wy165611/smart-warning-cone/docs/07-测试方案与数据记录表.md

# 测试方案与数据记录表

> **安全第一**：只在封闭场地（校内封闭道路、操场跑道、停车场空地）测试，使用自行车、电动车或遥控车，限速 30 km/h 以内，安排专人警戒。不得用车辆冲撞真人。

## 0. 已完成的软件验证（不需要硬件）

| 日期 | 项目 | 环境 | 结果 |
|---|---|---|---|
| 2026-11-01 | 四个固件编译 | arduino-cli，esp32:esp32 3.3.12，`esp32c3:CDCOnBoot=cdc`，Adafruit NeoPixel 1.15.5，PubSubClient 2.8 | 全部通过，`--warnings all` 无警告，程序空间 73%–74% |
| 2026-11-01 | 单元测试与静态检查 | Python 3.13，`pytest`、`ruff` | 23 项通过；lint、format 通过 |
| 2026-11-03 | 单元测试与静态检查 | Python 3.12.3，`pytest`、`ruff` | 34 项通过；`ruff check` 与 `ruff format --check` 通过 |
| 2026-11-03 | 四个固件编译 | arduino-cli 1.5.1，esp32:esp32 3.3.12，`esp32c3:CDCOnBoot=cdc`，Adafruit NeoPixel 1.15.5，PubSubClient 2.8 | `--warnings all` 无警告。程序空间上限 1310720 字节：哨兵 980009（74%），联动 967545（73%），工人端 964461（73%），网关 975527（74%）。动态内存上限 327680 字节：哨兵 36728（11%），联动 37856（11%），工人端 37800（11%），网关 39040（11%） |
| 2026-11-01 | 平台端到端 | 本机 amqtt broker + `python -m sentinel` + `tools/simulator.py` | 节点、事件、统计、报告接口正常（当时的截图已替换） |
| 2026-11-03 | 平台端到端 | Mosquitto 2.0.18 + `python -m sentinel` + `tools/simulator.py` | 模拟数据，不是路试。预警等级先保持 0，再进入一级、二级，离开后回到 0。第一次通过：最高等级 2，最高车速 37.32 km/h，最小 TTC 1.08 s，最近 11.24 m，持续 10301 ms。五个节点在线。截图 `docs/assets/dashboard-sim.png` |

以下各节是**实物测试**，目前都还没有做，表格保持空白，填之前不要在申报书或 PPT 中引用任何实测数字。

## 1. 测试设备

- 测速参考：手持测速雷达枪，或电动车码表 / 手机 GPS 测速 App；
- 测距参考：卷尺或激光测距仪，在路面每 10 m 贴标记；
- 计时：手机 240fps 慢动作视频；
- 数据记录：`tools/radar_monitor.py --csv`、服务器数据库。

## 2. 测速测距精度

**方法**：电动车分别以 10、15、20、25、30 km/h 匀速驶向雷达，每档 5 次。读取经过 20 m、40 m 标记时雷达输出的速度与距离。

| 序号 | 参考速度 km/h | 雷达速度 km/h | 误差 | 参考距离 m | 雷达距离 m | 误差 |
|---|---|---|---|---|---|---|
| 1 | | | | | | |
| 2 | | | | | | |
| … | | | | | | |

统计：平均绝对误差（MAE）、最大误差。

## 3. 最远检测距离

**方法**：车辆从 120 m 外驶来，记录雷达首次稳定检测到目标的距离。分白天/夜间/小雨各 5 次。

| 条件 | 1 | 2 | 3 | 4 | 5 | 平均 |
|---|---|---|---|---|---|---|
| 白天 | | | | | | |
| 夜间 | | | | | | |
| 小雨 | | | | | | |

## 4. 预警提前量

**方法**：车辆以 20、30 km/h 驶向锥桶，用视频记录一级、二级预警触发时刻和车辆到达锥桶时刻。

| 速度 | 一级触发距离 m | 一级提前量 s | 二级触发距离 m | 二级提前量 s |
|---|---|---|---|---|
| 20 | | | | |
| 30 | | | | |

## 5. 误报 / 漏报

- **误报**：锥桶放置 30 分钟，无测试车辆驶向锥桶（可有行人、旁边车道远离车辆），记录误触发次数。
- **漏报**：车辆以超过阈值的条件驶近 20 次，记录未触发次数。

| 项目 | 次数 | 触发/未触发 | 比率 |
|---|---|---|---|
| 误报（30 min 观察） | | | |
| 漏报（20 次驶近） | | | |

## 6. 联动延迟

**方法**：锥桶间隔 5 m 一字排开，手机慢动作同时拍下哨兵与末端锥桶，逐帧计算从哨兵变色到末端锥桶变色的时间差。重复 10 次。

| 次数 | 1 | 2 | 3 | 4 | 5 | 6 | 7 | 8 | 9 | 10 | 平均 |
|---|---|---|---|---|---|---|---|---|---|---|---|
| 延迟 ms | | | | | | | | | | | |

## 7. 通信距离

联动锥桶逐步远离哨兵，每 10 m 测试 20 次预警，记录接收成功率，分开阔地与有遮挡。

## 8. 续航

满电后持续工作（每 30 s 模拟一次预警），每小时记录电池电压，直到低于 3.3 V。

| 时间 h | 0 | 1 | 2 | 3 | 4 | 5 | 6 | 7 | 8 | … |
|---|---|---|---|---|---|---|---|---|---|---|
| 哨兵电压 V | | | | | | | | | | |
| 联动电压 V | | | | | | | | | | |

## 9. 语音识别率

安静环境与模拟施工噪声（手机播放路面施工噪声）下，每条命令说 20 次。

| 命令 | 安静识别率 | 噪声识别率 |
|---|---|---|
| 开始作业 | | |
| 左侧封道 | | |
| 雨天模式 | | |

## 10. 司机感知对比（可选，提升说服力）

找 10 名同学骑电动车经过作业区，分别在“普通锥桶”与“智能锥桶”两种情况下，记录开始减速的距离，并做问卷（是否注意到、是否醒目）。
