wy165611/smart-warning-cone/docs/01-申报书.md

# 作品申报书（Markdown 版）

> 本文是 `competition/challenge-cup/哨兵_挑战杯作品申报书.docx` 的文字底稿，内容与 docx 保持一致，便于在 Git 中审阅修改。正式提交时以第二十届“挑战杯”组委会和学校下发的模板为准，逐栏誊入。
>
> 【填】【待补充】处必须由团队用真实材料替换；没有材料的栏目宁可写“暂无”，也不要估填。所有数字都应能在下文“参考资料”或仓库代码中找到出处。

| 栏目 | 内容 |
|---|---|
| 作品全称 | 哨兵——基于毫米波雷达与协同组网的公路养护作业区智能预警锥桶系统 |
| 竞赛 | 第二十届“挑战杯”全国大学生课外学术科技作品竞赛（2027 年决赛）· 科技发明制作类 |
| 建议类别 | 科技发明制作 B 类（投入较少、为生产技术或社会生活带来便利的小发明、小制作）；学校认为够 A 类时再调整 |
| 建议分组 | A．机械与控制（含交通）；若学校按电子信息归口，改选 B．信息技术 |
| 学校 / 学院 | 山东理工大学 交通与车辆工程学院【请核对】 |
| 团队 | 【填：集体名称、队员姓名、专业、年级】 |
| 指导教师 | 【填：姓名、职称、单位】 |
| 作品阶段 | 实验室阶段：软件与固件完成并通过编译和联调；实物样机与封闭场地测试【待补充】 |

## 一、作品目的

公路养护常常在不中断交通的情况下进行。作业人员面向路面、背对来车，现场机械噪声大；司机看到的则是临时压缩的车道和一排静止的锥桶。锥桶、标志和隔离设施负责“隔开”和“告知”，但它们本身不知道某一辆车是否正在快速接近。

美国联邦公路局（FHWA）2026 年发布的工作区安全宣传资料显示：2024 年美国工作区交通事故死亡 850 人；超过一半的致死事故发生在夜间；追尾占致死事故的近四分之一；超速是三分之一以上致死事故的因素【参考资料 7】。这是美国的数据，只说明“作业区被来车撞击”是一个被持续统计的风险，不能直接代表我国情况。国内可引用的典型案例：2026 年 1 月 7 日，345 国道靖江段养护作业区发生货车分心驾驶追尾施工保护车事故，致 3 人死亡、1 人重伤、1 人轻伤【参考资料 14】。这是地方公安机关公示的一起较大道路交通事故，不是全国养护作业区伤亡汇总；全国起数与死亡人数仍【待补充：官方汇总表及出处】。

我国公路规模大、养护任务重：截至 2025 年末，全国公路里程 557.89 万公里，其中农村公路 471.12 万公里（县道 70.57、乡道 124.03、村道 276.52 万公里）【参考资料 1】。大量日常小修保养作业时间短、人员少，通常只摆放锥桶和标志。

本作品的目的，是在不替代 JTG H30—2015《公路养护安全作业规程》和 GB 5768.4—2017《道路交通标志和标线 第 4 部分：作业区》所要求设施的前提下【参考资料 2、3】，给普通锥桶增加一层**低成本的主动提醒**：测到来车，算出碰撞时间，按危险程度分级提醒司机和工人，并把每一次接近记录下来。

## 二、基本思路

1. **感知**：在作业区上游放置“哨兵锥桶”，用海凌科 HLK-LD2451 24 GHz 雷达测量来车的距离、速度和方向。厂家标称最远感应 100 m（10–100 m 可调），水平 ±15°、垂直 ±7°【参考资料 11】。
2. **判定**：只保留“靠近、速度 ≥ 5 km/h、距离 ≤ 100 m”的目标，选碰撞时间（TTC）最小者；距离、速度各经一维卡尔曼滤波后计算 TTC，按“TTC + 超速”双判据分成安全 / 一级 / 二级。
3. **联动**：哨兵通过 ESP-NOW 广播预警。ESP-NOW 是乐鑫定义的无连接 Wi-Fi 通信方式，节点之间不需要路由器【参考资料 13】。联动锥桶按编号错相点亮形成流水灯；工人报警器在二级预警时震动并蜂鸣。
4. **部署**：ASRPRO 离线语音识别“开始作业”“左侧封道”“雨天模式”等命令，经 4 字节串口帧交给哨兵，再广播给所有锥桶。
5. **记录**：网关把 ESP-NOW 报文转成 MQTT，平台（FastAPI + SQLite）入库，看板显示实时曲线和事件列表，并生成文字版安全报告。

所有预警判定都在哨兵本地完成，网关和平台断开时，锥桶之间的预警仍然工作。

## 三、创新点（设计特点）

以下是方案的设计特点，不是“已经证明优于某产品”的实验结论。

1. **按危险程度提醒**：用 TTC 与超速两个条件分级，平时慢闪，危险时才升级，而不是固定频率一直闪。
2. **一次判定同时提醒司机和工人**：司机看到锥桶灯光和流水灯，背对来车的工人收到穿戴端的震动和蜂鸣，两边使用同一个等级。
3. **锥桶之间无基础设施组网**：ESP-NOW 广播、序号去重、最多 2 跳中继，模式配置也会被联动锥桶转发一次。
4. **环境系数可一键切换**：雨天 ×1.4、夜间 ×1.2，可叠加；语音切换，不用掏手机。
5. **接近事件结构化记录**：每次车辆接近结束后上报最高等级、最高车速、最小 TTC、最近距离和持续时间，为后续标定和管理提供原始数据。

FHWA 的夜间作业区安全专题把“顺序点亮的警示灯（sequential lights）”和“车辆进入作业区时提醒工人的自动入侵报警”列为推广策略【参考资料 8】，说明本作品的两个方向在国外实践中都有对应做法。本作品的差别在于用一个低成本雷达节点把**提前的 TTC 分级**、**流水灯**、**工人端提醒**和**事件记录**放在同一条链路里。是否因此获得更长的有效提前量，需要封闭场地对比试验验证【待补充】。

## 四、技术关键

1. LD2451 串口帧解析（帧头 `F4 F3 F2 F1`，帧尾 `F8 F7 F6 F5`，方向按协议表 9：`0x01` 靠近）与多目标中“最危险目标”的选择【参考资料 12】；
2. 一维卡尔曼滤波（Q = 0.5，R = 4）抑制单帧跳变；
3. 连续 3 帧确认才升级、目标消失 1.5 s 后解除（按时间判断，雷达掉线也能解除）；
4. 广播组网的序号去重、随机退避、重启后随机起号；
5. 户外供电：雷达需要 5 V、供电能力大于 200 mA，平均工作电流 107 mA【参考资料 11】。

## 五、主要技术参数（设计值）

| 项目 | 数值 | 来源 |
|---|---|---|
| 探测距离 / 视场 | ≤ 100 m；水平 ±15°、垂直 ±7° | 厂家手册（未复测） |
| 雷达输出 | 有目标约 100 ms 一帧，无目标约 1 s 一帧 | 厂家手册 |
| 一级预警 | TTC < 5 s，或车速 > 40 km/h × 1.2 | `firmware/common/config.h` |
| 二级预警 | TTC < 2.5 s | 同上 |
| 环境系数 | 雨天 ×1.4，夜间 ×1.2，叠加 ×1.68 | 同上 |
| 确认 / 解除 | 连续 3 帧升级；目标消失 1.5 s 解除 | 同上 |
| 组网 | ESP-NOW 广播，预警期间每 200 ms 重发，中继 ≤ 2 跳 | 同上 |
| 物料估算 | 哨兵约 115 元；演示套装（1 哨兵 + 2 联动 + 1 工人端 + 1 网关 + 辅料）约 350 元 | `docs/02-物料清单BOM.md`，按网店常见价估算 |

这些阈值是设计初值，**尚未经过实测标定**。

## 六、科学性与先进性

- **判据**：TTC 由 Hayward（1972）提出，用“若保持当前速度和路径，距离碰撞还剩多少时间”衡量交通冲突的危险程度【参考资料 9】。本作品取 TTC = d /(v/3.6)。
- **滤波**：卡尔曼滤波（Kalman，1960）【参考资料 10】的一维常值形式，计算量小，适合在 ESP32-C3 上逐帧运行。
- **定位**：美国 23 CFR 630.1108 把入侵报警、速度管理和 ITS 列为“其他交通控制措施”，同时说明执法车辆不能代替临时交通控制设施【参考资料 6】。本作品同样定位为既有设施之上的补充。
- **已有验证**（2026-11-03，都不是路试）：
  - 四个固件在 Arduino-ESP32 核心 3.3.12（arduino-cli 1.5.1，`esp32:esp32:esp32c3:CDCOnBoot=cdc`，Adafruit NeoPixel 1.15.5、PubSubClient 2.8）下编译通过，`--warnings all` 无警告。程序空间：哨兵 980009 字节（74%），联动 967545 字节（73%），工人端 964461 字节（73%），网关 975527 字节（74%），上限 1310720 字节。动态内存：哨兵 36728 字节（11%），联动 37856 字节（11%），工人端 37800 字节（11%），网关 39040 字节（11%），上限 327680 字节。
  - Python 3.12.3 上 `pytest` 34 项通过（含非作业模式、毫秒时钟回绕、半包心跳、语音帧重同步），`ruff check` 与 `ruff format --check` 通过。
  - 本机 Mosquitto 2.0.18 + 平台 + `tools/simulator.py` 端到端运行。模拟器按三帧确认发预警；第一次通过日志为最高等级 2、最高车速 37.32 km/h、最小 TTC 1.08 s。五个节点在线，统计和报告与该事件一致。这是模拟数据。
- **尚未完成**：实物烧录、测速测距误差、提前量、误报漏报、联动延迟、通信距离、续航，见第七节。

| 现有方式 | 局限（功能层面） | 本作品的做法 |
|---|---|---|
| 锥桶 / 水马 / 标志 | 隔离和告知，不感知来车 | 增加雷达感知与分级提醒，不替换原设施 |
| 定频爆闪灯 | 不区分危险程度 | 平时慢闪，危险时升级并联动流水灯 |
| 闯入式报警（压感管、红外对射等） | 车辆越过检测线才报警 | 车辆仍在雷达范围内时按 TTC 提前分级 |
| 带情报板和平台的大型系统 | 设备多、部署重 | 节点即放即用，网关和平台可选 |
| 防撞缓冲车 | 减轻后果 | 事前提醒，可与之互补 |

以上为功能分类，不是对具体产品的测评。【待补充：国内文献和在售产品的名称、参数和价格，附出处】

## 七、测试计划与结果

测试只在封闭场地进行，用自行车或电动车，车速不超过 30 km/h，专人警戒，不用车辆冲向真人。方法见 `docs/07-测试方案与数据记录表.md`。

| 指标 | 目标值 | 实测值 |
|---|---|---|
| 测速误差 | ≤ ±3 km/h | 【待补充】 |
| 测距误差 | ≤ ±2 m | 【待补充】 |
| 最远稳定检测距离 | ≥ 80 m | 【待补充】 |
| 一级预警提前量（20/30 km/h） | ≥ 4 s | 【待补充】 |
| 误报率（30 min 观察） | ≤ 5% | 【待补充】 |
| 漏报率（20 次驶近） | ≤ 2% | 【待补充】 |
| 联动延迟（哨兵→末端锥桶） | ≤ 100 ms | 【待补充】 |
| 续航（3000 mAh） | ≥ 8 h | 【待补充】 |

目标值是团队自定的验收线，不是标准要求。

## 八、使用说明与适用范围

1. **布设**：按 JTG H30 和 GB 5768.4 设置作业区后，把哨兵放在作业区上游、雷达朝来车（建议 50–150 m，按限速与视距在现场确定）；联动锥桶沿过渡段摆放，编号从哨兵往作业区递增；工人佩戴报警器；网关放在作业车上。
2. **启动**：说“小哨兵”唤醒，再说“开始作业”；按需说“左侧封道 / 右侧封道”“雨天模式”“夜间模式”。
3. **运行**：安全时黄灯慢闪；一级红黄快闪、联动锥桶流水灯；二级红色爆闪 + 蜂鸣，工人报警器震动。
4. **收工**：说“结束作业”，平台可导出当日安全报告。

**可能适用**：占一条车道、当天收工的小修保养，县乡公路和城市道路的日常修补，事故现场的临时管控。**不适用**：替代防撞缓冲车；未标定前作为测速执法证据；未完成防水和电气安全设计前长期无人值守。

## 九、推广前景（待调研）

- 可能的用户：公路养护单位、市政道路养护单位、高速公路运营单位、路政与交警。
- 可能的形式：整套锥桶、只卖灯头改装模块、数据平台服务。
- 【待补充：走访 2～3 家养护单位，记录作业频次、现有设施、采购意愿和可接受价格】
- 【待补充：同类产品价格调研与量产成本估算】在此之前不写市场规模和销售额。

## 十、团队分工（示例，按实际修改）

| 成员 | 专业 | 分工 |
|---|---|---|
| 【填】（负责人） | 交通工程 | 需求调研、预警算法、测试方案、申报书 |
| 【填】 | 电子信息 | 硬件选型、电路与 PCB、电源、固件 |
| 【填】 | 计算机 | 组网通信、平台开发 |
| 【填】 | 设计 / 经管 | 外壳结构、市场调研、答辩与视频 |

## 十一、预期成果

1. 工程样机 1 套（≥ 3 个锥桶 + 工人端 + 网关）【待补充：完成情况与照片】；
2. 作业区安全看板与报告软件 1 套（已完成，见 `sentinel/`、`server/`）；
3. 封闭场地测试报告与演示视频【待补充】；
4. 知识产权【待补充：如已申请，填写申请号；未申请则写“暂无”】。

## 十二、经费预算（估算）

| 项目 | 金额（元） | 说明 |
|---|---|---|
| 元器件 | 400 | 演示套装约 350 元 + 损耗备件 |
| PCB 打样 | 150 | 2 层板打样 |
| 3D 打印与结构件 | 150 | 灯头外壳、支架 |
| 测试耗材 | 100 | 锥桶、标记、反光材料 |
| 资料与其他 | 200 | 按实际 |
| **合计** | **1000** | 估算，按实际票据调整 |

## 十三、风险与对策

| 风险 | 对策 |
|---|---|
| 护栏、标志牌反射造成误报 | 只追踪靠近目标、最低速度和距离窗口、连续 3 帧确认；用官方 App 收窄检测范围 |
| 白天强光下灯光不醒目 | 提高亮度、加遮光罩，二级预警同时用声音 |
| 续航不足 | 无车时降低亮度，预留太阳能补电接口 |
| 无线丢包 | 预警期间每 200 ms 重发、联动锥桶 / 工人端 / 网关按序号去重、两跳中继；3 s 收不到刷新自动回到安全状态 |
| 测试安全 | 只在封闭场地低速测试，专人警戒 |

## 参考资料

只列本仓库编写时打开过原文或官方记录页的资料（2026-11-04 核对）。

1. 交通运输部. 2025 年交通运输行业发展统计公报. <https://xxgk.mot.gov.cn/jigou/zhghs/202606/t20260618_4207752.html>
2. 交通运输部. 关于发布《公路养护安全作业规程》的公告（2015 年第 16 号）. <https://xxgk.mot.gov.cn/jigou/glj/202006/t20200623_3312282.html>
3. 国家标准全文公开系统. GB 5768.4—2017 道路交通标志和标线 第 4 部分：作业区. <https://openstd.samr.gov.cn/bzgk/std/newGbInfo?hcno=81495E87EE21D71FCC2759945539504F>
4. 中共中央、国务院. 交通强国建设纲要. <https://www.gov.cn/gongbao/content/2019/content_5437132.htm>
5. 交通运输部. 关于推进公路数字化转型 加快智慧公路建设发展的意见（交公路发〔2023〕131 号）. <https://xxgk.mot.gov.cn/jigou/glj/202309/t20230920_3922478.html>
6. 23 CFR 630.1108 Work zone safety management measures and strategies. <https://www.ecfr.gov/current/title-23/chapter-I/subchapter-G/part-630/subpart-K/section-630.1108>
7. FHWA. 2026 National Work Zone Awareness Week Fact Sheet (FHWA-HOP-26-060). <https://ops.fhwa.dot.gov/publications/HOP-26-060_FHWA_NWZAW_Factsheet.pdf>
8. FHWA. EDC-8: Advancing Nighttime Work Zone Safety. <https://www.fhwa.dot.gov/innovation/everydaycounts/edc_8/nighttime_work_zone_safety.cfm>
9. Hayward J C. Near-miss determination through use of a scale of danger. Highway Research Record, 1972, 384: 24-34. <https://onlinepubs.trb.org/Onlinepubs/hrr/1972/384/384-004.pdf>
10. Kalman R E. A new approach to linear filtering and prediction problems. Journal of Basic Engineering, 1960, 82(1): 35-45. <https://asmedigitalcollection.asme.org/fluidsengineering/article-abstract/82/1/35/397706/A-New-Approach-to-Linear-Filtering-and-Prediction>
11. 海凌科. HLK-LD2451 使用手册 V1.03. <https://h.hlktech.com/download/HLK-LD2451-24G/1/HLK-LD2451%E4%BD%BF%E7%94%A8%E6%89%8B%E5%86%8C_V1.03%20.pdf>
12. 海凌科. LD2451 串口通信协议 V1.03. <https://h.hlktech.com/download/HLK-LD2451-24G/1/LD2451%20%E4%B8%B2%E5%8F%A3%E9%80%9A%E4%BF%A1%E5%8D%8F%E8%AE%AE%20V1.03.pdf>
13. Espressif. ESP-NOW（ESP-IDF 编程指南）. <https://docs.espressif.com/projects/esp-idf/en/stable/esp32c3/api-reference/network/esp_now.html>
14. 泰州市公安局. 345国道泰州靖江市“1·7”较大道路交通事故处理情况公示. <https://gaj.taizhou.gov.cn/jwzx/tzgg/art/2026/art_d692699ed0c944bcaa4fa840ed0461ea.html>
