wy165611/smart-warning-cone/competition/challenge-cup/哨兵_挑战杯答辩PPT.pptx

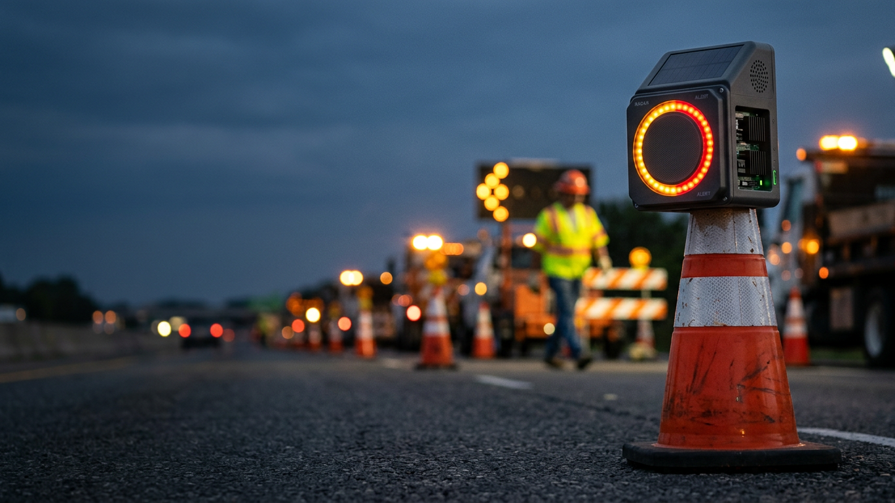
[picture p2: figure]

第二十届“挑战杯”全国大学生课外学术科技作品竞赛
科技发明制作类（B 类）

哨 兵

基于毫米波雷达与协同组网的
公路养护作业区智能预警锥桶系统

让锥桶测到来车，按危险程度提醒

答辩人 【填】 团队成员 【填】 指导教师 【填】
山东理工大学 交通与车辆工程学院 【请核对】

校徽

背景为 AI 生成的概念图，答辩前替换为实物照片

Notes: 各位评委老师好，我们是“哨兵”团队。作品是基于毫米波雷达与协同组网的公路养护作业区智能预警锥桶系统：让锥桶能测到来车，并按危险程度提醒司机和工人。下面按背景问题、方案设计、关键技术、验证情况、创新与计划五部分汇报。【封面：答辩人、团队成员、指导教师、校徽、学校学院按实际填写和核对；背景图为 AI 生成的概念图，答辩前换成实物照片】

## Slide 2

目录

CONTENTS

01

02

03

背景问题

作业区风险与现有设施的缺口

方案设计

四类节点 · 三层架构 · 现场布设

关键技术

TTC 分级 · 滤波防误报 · 组网

04

05

验证情况

已完成的软件验证 · 待做的实测

创新计划

作品特点 · 应用路径 · 团队计划

Notes: （目录页，带过即可）

## Slide 3

01 背景问题

作业区是来车风险集中的地方

边通车边施工：工人背对来车，现场噪声大

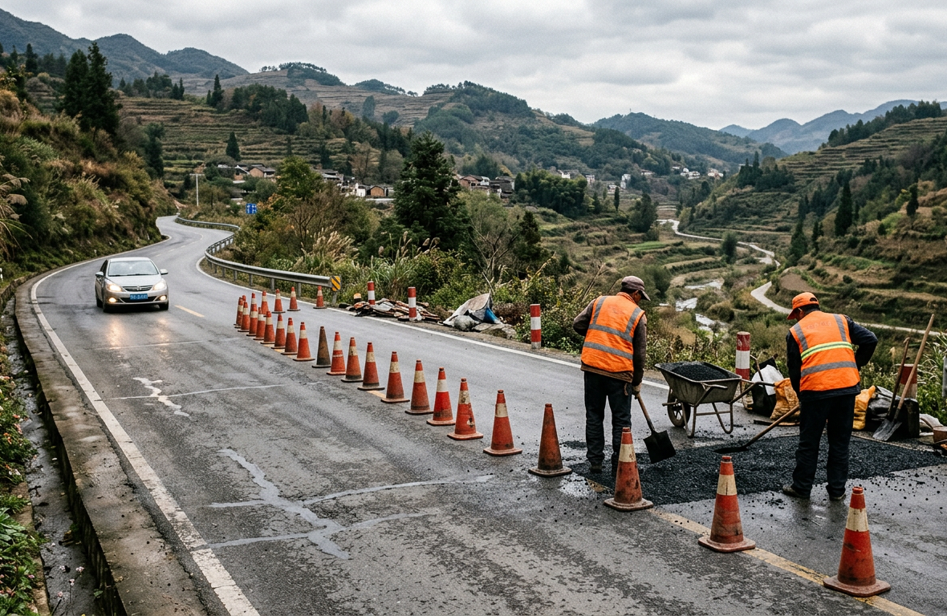
[picture p3: figure]

示意图（AI 生成），答辩前替换为团队实地调研照片

850 人

2024 年美国工作区交通事故死亡
2023 年为 905 人

过半

致死事故发生在夜间；追尾约占四分之一

来源：FHWA-HOP-26-060 [8] · 美国数据，不代表我国

国内典型案例：2026-01-07，345 国道靖江段养护作业区：货车分心驾驶追尾施工保护车，致 3 死 2 伤[16]
这是地方公安机关公示的一起较大道路交通事故，不是全国养护作业区伤亡汇总；全国起数与死亡人数仍缺可引用的官方汇总表。

哨兵 · 公路养护作业区智能预警锥桶

3

Notes: 养护作业通常边通车边施工，工人面向路面、背对来车，机械噪声大。美国联邦公路局2026年的资料显示，2024年美国工作区交通事故死亡850人（2023年905人），超过一半的致死事故发生在夜间，追尾约占四分之一。这是美国数据，我们只用它说明这类风险被持续统计，不能代表我国。国内可引用的典型案例：2026-01-07，345 国道靖江段养护作业区：货车分心驾驶追尾施工保护车，致 3 死 2 伤（泰州市公安局公示[16]）。这是地方公安机关公示的一起较大道路交通事故，不是全国养护作业区伤亡汇总；全国起数与死亡人数仍缺可引用的官方汇总表。我国到2025年末公路里程557.89万公里，其中农村公路471.12万公里（交通运输部统计公报[1]），日常小修保养点多面广。

## Slide 4

01 背景问题

现有设施能隔离和告知，但看不到来车

按功能划分，不涉及具体产品的性能和价格

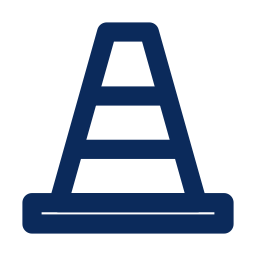
[picture p4: figure]
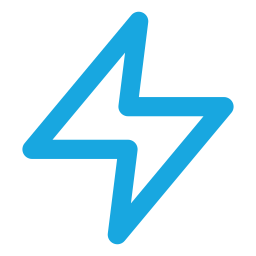
[picture p5: figure]
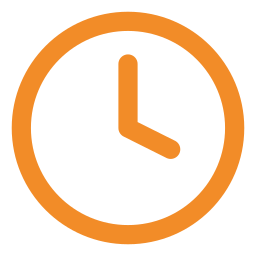
[picture p6: figure]
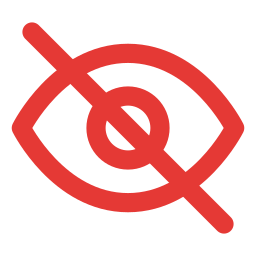
[picture p7: figure]
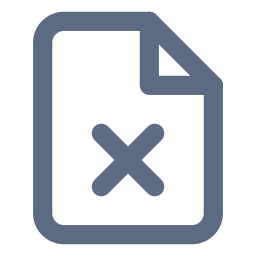
[picture p8: figure]

被动

只能隔离和告知

不分级

固定频率闪烁

滞后

越界后才报警

盲区

工人背对来车

无记录

危险接近无法复盘

目标：在规范设施之外，给普通锥桶加一层主动提醒

测到来车 → 算出还剩几秒 → 按危险程度提醒司机和工人 → 留下记录

哨兵 · 公路养护作业区智能预警锥桶

4

Notes: 按功能看，现有设施有五个缺口：锥桶、水马、标志牌是被动的，只能隔离和告知；爆闪灯固定频率闪烁，不区分车辆危险程度；入侵报警多在车辆越界或碰撞后才触发；工人背对来车、噪声大，很难察觉；危险接近发生过几次，事后没有记录、无法查证。我们的目标是在规范要求的设施之外，给普通锥桶加一层主动提醒：测到来车、算出还剩几秒、按危险程度提醒司机和工人，并留下记录。

## Slide 5

01 背景问题

依据与定位：补充，而不是替代

标准规定设施怎么摆，本作品负责“看见来车”

JTG H30—2015 [2]

管理

接近事件入库 · 安全报告 · 复盘

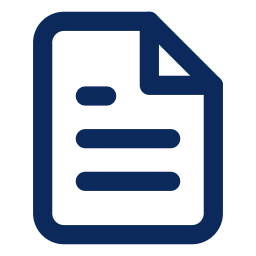
[picture p9: figure]

公路养护安全作业规程

GB 5768.4—2017 [3]

道路交通标志和标线 第 4 部分：作业区

本作品

测距测速 → TTC 分级 → 多端提醒

23 CFR 630.1108 [7]

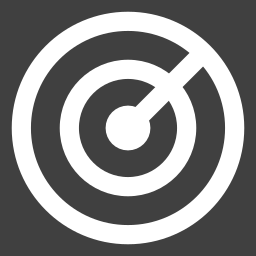
[picture p10: figure]

入侵报警、速度管理、ITS 列为可选措施

规范设施

标志 · 锥桶 · 防撞设施（按规范布设）

FHWA EDC-8 [9]

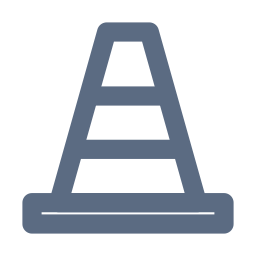
[picture p11: figure]

夜间作业区推广自动入侵报警、顺序警示灯

入侵报警、顺序警示灯在国外已有应用，本作品不是首创，定位是低成本集成

哨兵 · 公路养护作业区智能预警锥桶

5

Notes: 我们的定位是补充而不是替代。作业区怎么划分、标志和锥桶怎么摆，按JTG H30—2015《公路养护安全作业规程》和GB 5768.4—2017执行；美国联邦法规23 CFR 630.1108把入侵报警、速度管理、智能交通系统列为可选措施，联邦公路局EDC-8夜间作业区专题也在推广自动入侵报警和顺序点亮的警示灯。所以这类思路不是我们首创，我们的特点是把TTC提前分级、流水灯、工人穿戴端和事件记录集成到一个低成本的锥桶节点里。右侧三层：底层是规范设施，中间是本作品的主动预警，上层是管理与复盘。

## Slide 6

02 方案设计

方案总览：四类节点协同预警

卡装在标准锥桶顶部，不改造现有设施

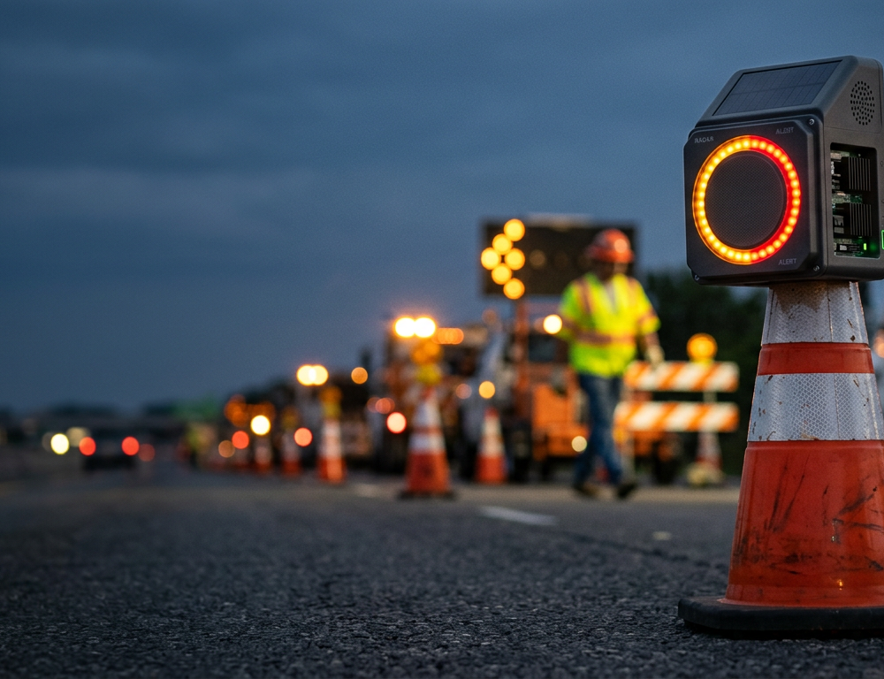
[picture p12: figure]
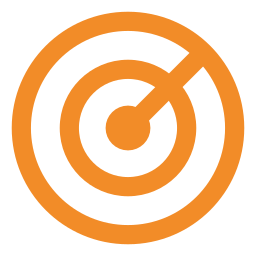
[picture p13: figure]

哨兵锥桶

雷达测距测速，计算 TTC，三级预警

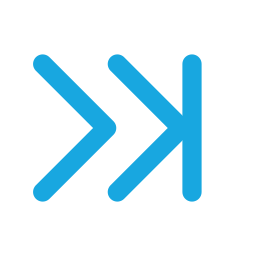
[picture p14: figure]

联动锥桶

接收预警，错相点亮形成流水灯

工人报警器

二级预警时震动 + 蜂鸣 + 红灯

网关与平台

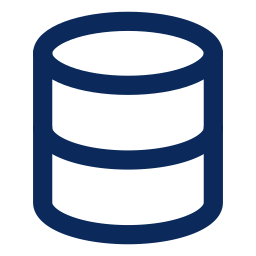
[picture p15: figure]

MQTT 上传 · 事件入库 · 安全报告

概念渲染图（AI 生成），答辩前替换为样机照片

哨兵 · 公路养护作业区智能预警锥桶

6

Notes: 系统由四类节点组成，都卡装在标准锥桶顶部，不改造现有设施。上游的哨兵锥桶用24GHz毫米波雷达测量来车距离和速度，计算碰撞时间做三级预警；联动锥桶通过ESP-NOW接收预警，按编号错相点亮形成流水灯；工人报警器在最危险的二级预警时震动、蜂鸣并亮红灯；网关把数据转成MQTT上传，平台记录每次接近事件，提供实时看板并生成安全报告。左图是AI生成的概念渲染图，答辩前换成样机照片。

## Slide 7

02 方案设计

三层架构：感知 — 边缘决策 — 平台

判定全部在锥桶本地完成，网关或平台断开时预警照常工作

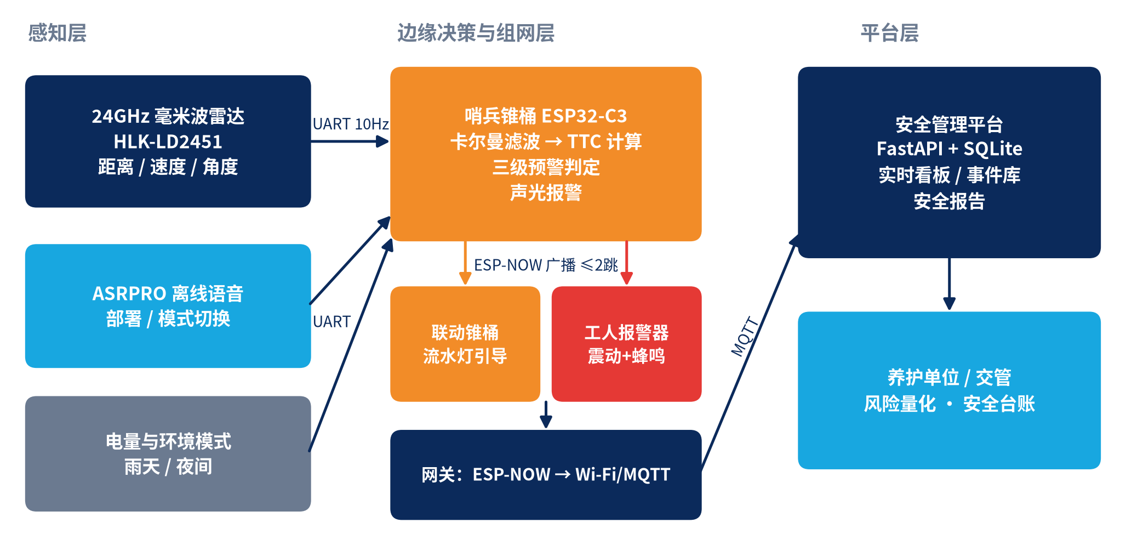
[picture p16: figure]

哨兵 · 公路养护作业区智能预警锥桶

7

Notes: 系统分三层。感知层是24GHz雷达、ASRPRO离线语音和电量与环境模式；边缘层由哨兵完成卡尔曼滤波、TTC计算和分级判定，通过ESP-NOW广播给联动锥桶和工人端，最多2跳；网关把报文转成MQTT上传平台，平台用FastAPI加SQLite，提供实时看板、事件库和安全报告。关键设计是判定全部在本地完成，网络中断不影响预警。

## Slide 8

02 方案设计

现场布设与使用流程

按 JTG H30 / GB 5768.4 设置作业区后，把哨兵放在上游、雷达朝来车

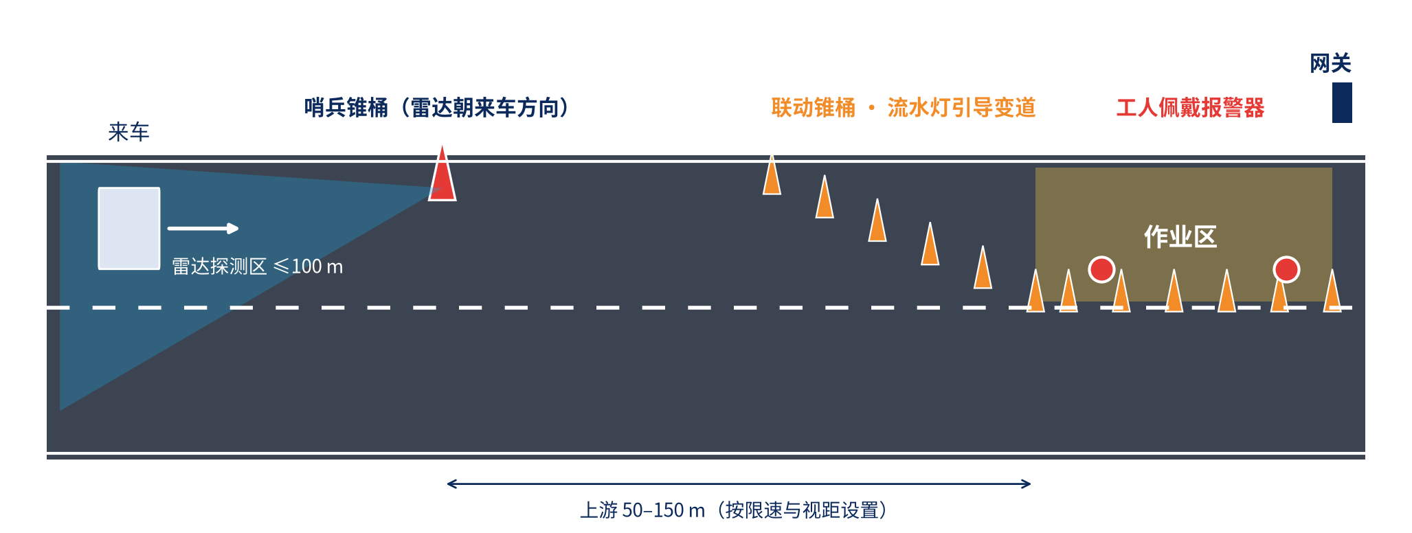
[picture p17: figure]
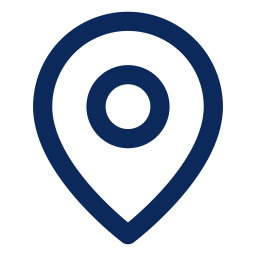
[picture p18: figure]

放置

上游放置，朝向来车

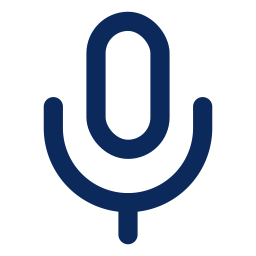
[picture p19: figure]

启动

语音“开始作业”

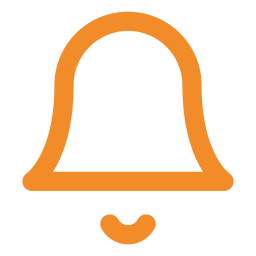
[picture p20: figure]

预警

声光、流水灯、震动

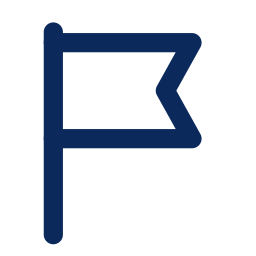
[picture p21: figure]

收工

“结束作业”出报告

哨兵 · 公路养护作业区智能预警锥桶

8

Notes: 现场使用分四步：先按规范设置作业区，再把哨兵放在上游，雷达朝向来车，具体距离按限速和视距确定，图中50到150米只是示意；联动锥桶沿过渡区摆放。对哨兵说“小哨兵，开始作业”启动，语音播报确认；有危险时自动声光报警、流水灯引导，并让工人报警器震动；收工说“结束作业”，平台生成安全报告。

## Slide 9

03 关键技术

TTC 与超速双判据，三级分级预警

TTC = 距离 ÷ 接近速度：车辆保持当前速度还需几秒到达 [11]

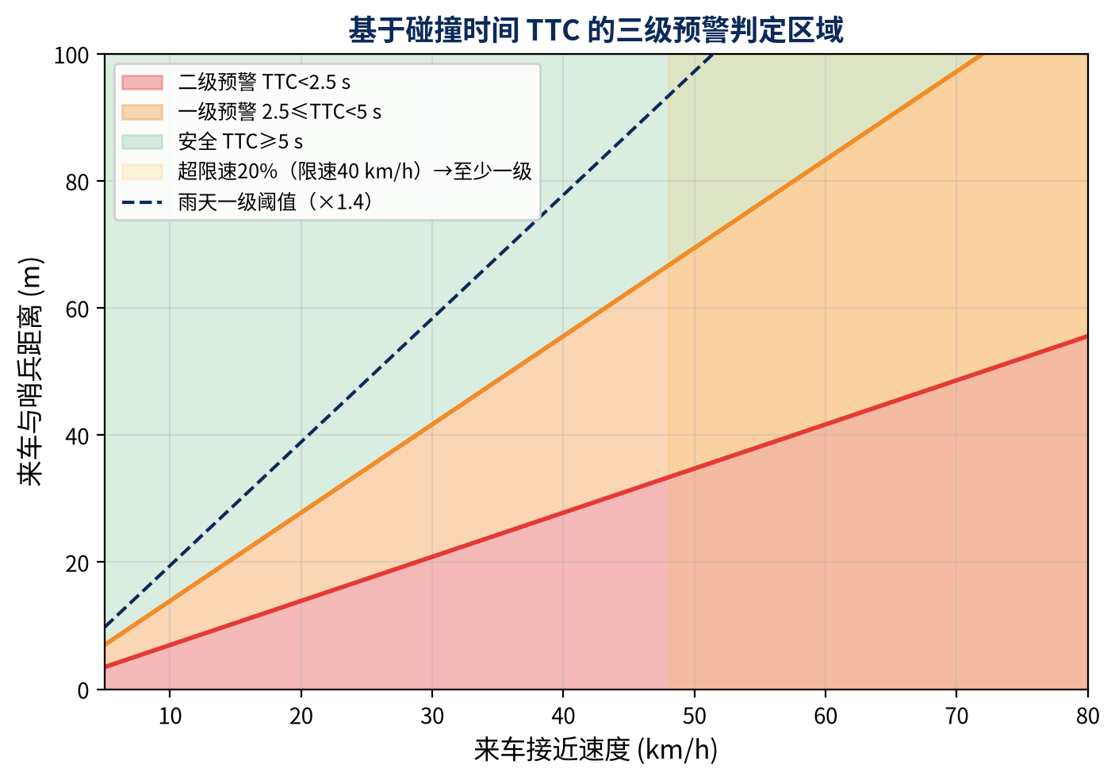
[picture p22: figure]

安全

TTC ≥ 5 s 且未超速

黄灯慢闪 · 工人端静默

一级

TTC < 5 s 或车速 > 40×1.2 km/h

红黄快闪 + 流水灯 · 工人端 LED

二级

TTC < 2.5 s

红色爆闪 + 蜂鸣 · 工人端震动

雨天 ×1.4　夜间 ×1.2（可叠加 ×1.68）
阈值与系数均为设计初值，需实测标定

哨兵 · 公路养护作业区智能预警锥桶

9

Notes: 判定用TTC，也就是车辆保持当前速度还需几秒到达，这一概念来自Hayward 1972年的交通冲突研究。TTC大于等于5秒且未超速为安全，黄灯慢闪；TTC小于5秒或车速超过限速40公里每小时的1.2倍触发一级，红黄快闪加流水灯，工人端LED提示；小于2.5秒触发二级，红色爆闪加蜂鸣，工人端震动。雨天阈值乘1.4，夜间乘1.2，可叠加为1.68，定性理由是湿滑路面制动距离更长、夜间视距更短。需要说明：这些阈值和系数是设计初值，要靠封闭场地实测来标定。

## Slide 10

03 关键技术

卡尔曼滤波 + 防误报措施

仿真：55 km/h 匀速接近，距离量测噪声 σ = 2 m（理论演示，非实测）

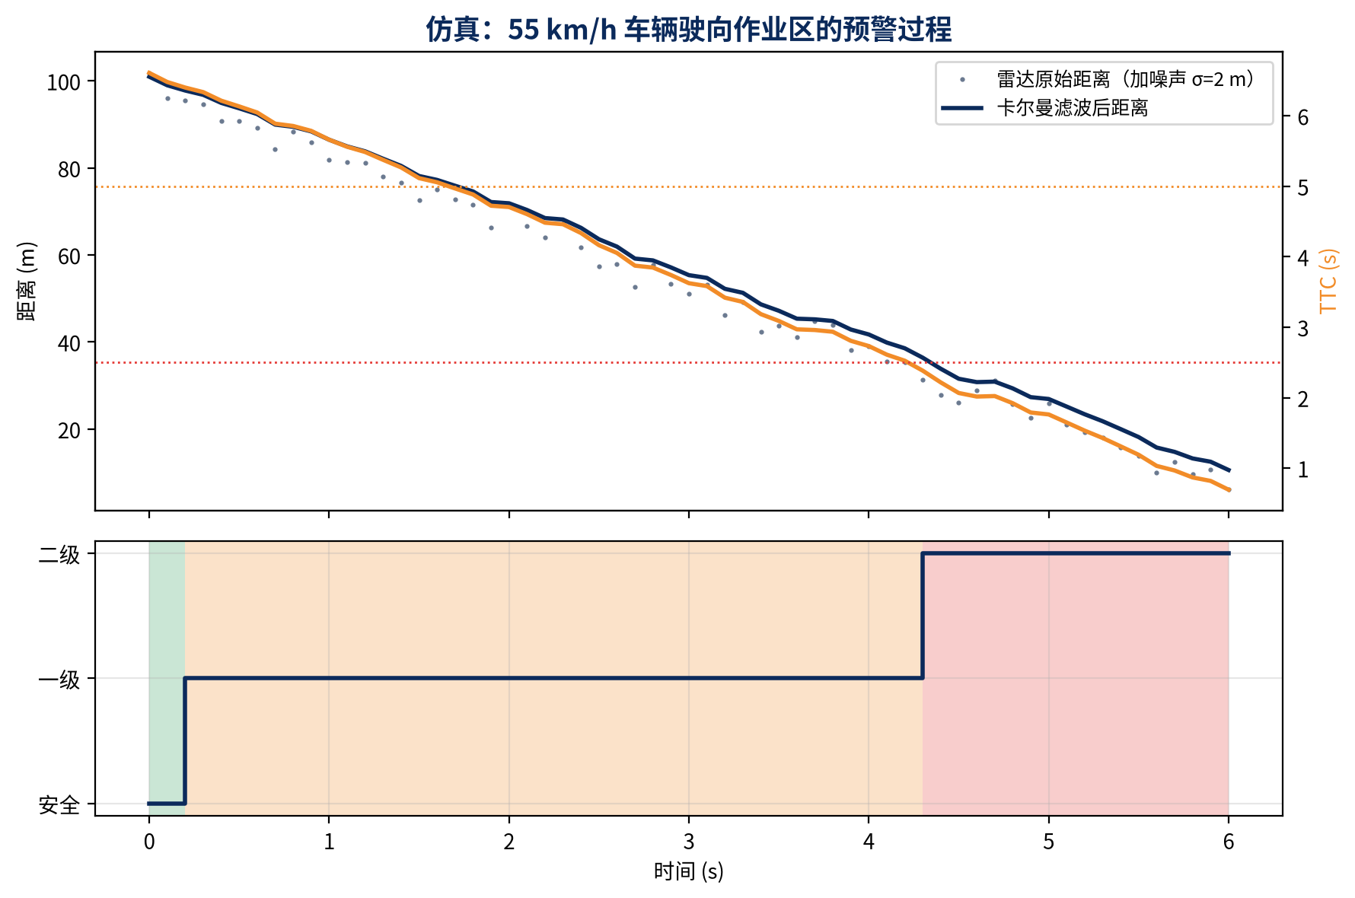
[picture p23: figure]

01

一维卡尔曼滤波

Q = 0.5，R = 4 [12]，平滑跳变

02

连续 3 帧确认

条件连续满足才升级

03

1.5 s 按时解除

雷达无帧或断线也能解除

04

目标筛选

只取接近、≥5 km/h、≤100 m

哨兵 · 公路养护作业区智能预警锥桶

10

Notes: 雷达读数会跳，我们用一维卡尔曼滤波平滑，参数Q取0.5、R取4；目标需连续3帧满足条件才升级；目标消失1.5秒后按时间解除，这个判断放在主循环里，雷达无帧甚至串口断开时也能按时解除；只跟踪接近、速度不低于5公里每小时、100米内的目标，多目标取TTC最小的一个。左图是仿真：55公里每小时已超过48公里每小时的超速线，第3帧即进入一级，TTC降到2.5秒以下时升级二级。这是理论演示，不是实测。

## Slide 11

03 关键技术

锥桶自组网：无需路由器的协同联动

ESP-NOW 广播 [15]：不依赖路由器和移动网络

2 跳

200 ms

3 s

32 位

最多两跳中继，扩大覆盖

预警期间重发间隔

收不到刷新即回安全

序号，按节点去重

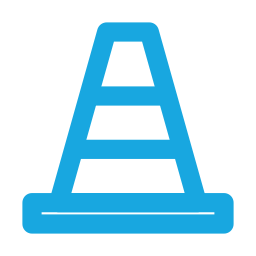
[picture p24: figure]
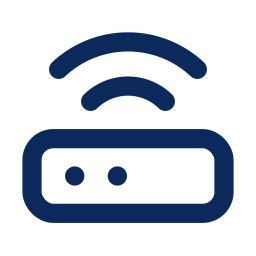
[picture p25: figure]

哨兵

联动锥桶

联动锥桶 n

工人端

网关

等级变化立即广播

去重后转发一次

错相点亮流水灯

二级：震动 + 蜂鸣

去重后转 MQTT

哨兵 · 公路养护作业区智能预警锥桶

11

Notes: 组网用ESP-NOW广播，不需要路由器和移动网络。哨兵等级变化立即广播，预警期间每200毫秒重发；联动锥桶按“节点号加32位序号”去重，随机退避后转发一次，最多2跳，并按编号错相点亮形成流水灯；工人端收到二级预警时震动加蜂鸣，并且用同一套序号去重，迟到的中继副本不会把已经解除的震动重新打开。模式不是作业中时，联动锥桶和工人端都回到安全。模式配置包（开始/结束作业、封道方向）同样去重后转发一次，离哨兵较远的锥桶也能切换；心跳与事件不转发，只由网关上传。联动锥桶和工人端3秒收不到刷新就回到安全状态，避免一直报警。网关对所有报文去重后转MQTT上传。

## Slide 12

03 关键技术

预警直达工人，语音一句话部署

补上“工人背对来车”的感知盲区；戴手套、无网络也能操作

工人报警器

离线语音“小哨兵”

一级预警

LED 提示

开始作业 / 结束作业

启动或收工

二级预警

震动 + 蜂鸣 + 红灯

左侧封道 / 右侧封道

流水灯方向

3 s 无刷新

自动回到安全

雨天模式 开 / 关

阈值 ×1.4

佩戴

夹在安全帽或反光背心上

夜间模式 开 / 关

阈值 ×1.2

物料估算约 31 元

【待补充：实际采购价】

报告电量 / 设备自检

电量与声光自检

哨兵 · 公路养护作业区智能预警锥桶

12

Notes: 工人报警器由ESP32-C3、振动马达、蜂鸣器和指示灯组成，锂电池供电，夹在安全帽或反光背心上：一级预警亮灯提示，二级预警震动加蜂鸣加红灯，解决工人背对来车、现场噪声大的问题；3秒收不到哨兵刷新自动回到安全。物料估算约31元，实际采购价待补充。部署用ASRPRO离线语音识别，唤醒词是“小哨兵”，识别结果以4字节帧（9600 8N1）发给哨兵；可以开始和结束作业、切换封道方向和雨天夜间模式、播报电量是否充足和做声光自检。戴手套、无网络也能操作。

## Slide 13

03 关键技术

硬件选型与物料估算

哨兵节点约 115 元，演示套装约 350 元（按常见零售价估算，未含外壳与运费）

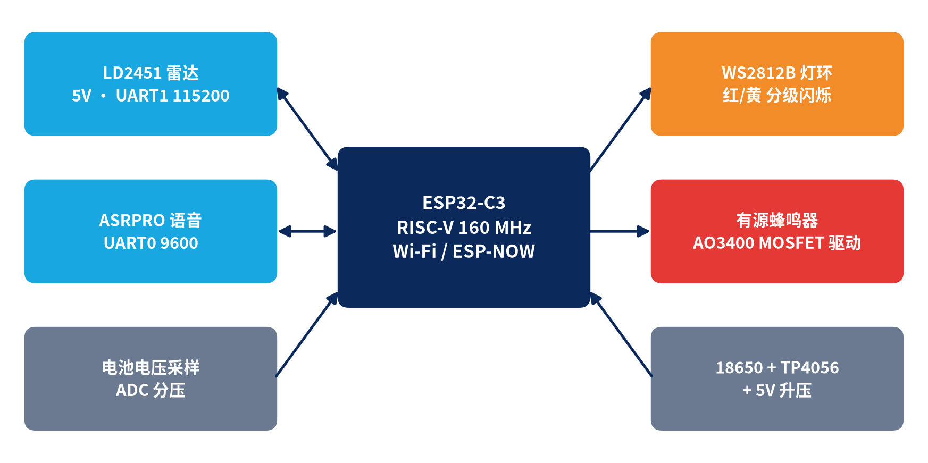
[picture p26: figure]

LD2451 24 GHz 雷达：标称 ≤100 m [13]
ESP32-C3：RISC-V，支持 Wi-Fi 与 ESP-NOW

单节点物料估算（元）

哨兵锥桶

115

联动锥桶

45

工人报警器

31

网关

12

【待补充：实际采购价与发票】

哨兵 · 公路养护作业区智能预警锥桶

13

Notes: 主控用ESP32-C3（RISC-V，支持Wi-Fi与ESP-NOW）；雷达用海凌科HLK-LD2451，24GHz，手册标称最远约100米；电源是18650锂电加TP4056充电和5伏升压。按常见零售价估算，哨兵节点约115元，联动锥桶约45元，工人报警器约31元，网关约12元，演示套装约350元，未含外壳与运费。实际采购价以发票为准，待补充。

## Slide 14

04 验证情况

已完成：软件链路验证

编译、单元测试与模拟器联调均在 2026-11-03 复跑

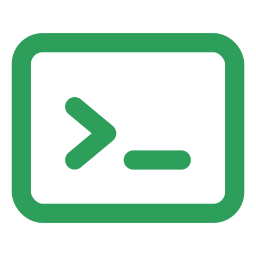
[picture p27: figure]

固件编译通过


2026-11-03 模拟器数据，不是实测

Flash 73%～74% · RAM 11%

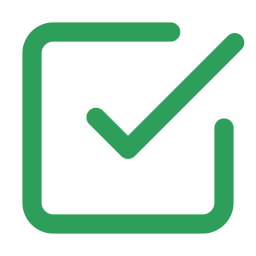
[picture p28: figure]

单元测试通过

Python 参考实现 34 项测试

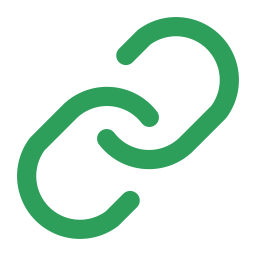
[picture p29: figure]

端到端联调打通

模拟器 → 入库 → 看板 → 报告

尚未完成：实物样机与封闭场地实测（见第 16 页）

哨兵 · 公路养护作业区智能预警锥桶

14

Notes: 2026-11-03 重新做了三件软件验证。一是四个草图在Arduino-ESP32 核心 3.3.12、arduino-cli 1.5.1 下编译通过，--warnings all 无警告。程序空间：哨兵 980009 字节（74%），联动 967545 字节（73%），工人端 964461 字节（73%），网关 975527 字节（74%），上限 1310720 字节。动态内存：哨兵 36728 字节（11%），联动 37856 字节（11%），工人端 37800 字节（11%），网关 39040 字节（11%），上限 327680 字节。二是 Python 参考实现 34 项单元测试通过。三是本机 Mosquitto 加模拟器跑通入库、看板和安全报告。右图是这次模拟器的看板，不是实测。模拟器第一次通过的日志是最高等级 2、车速 37.32 公里每小时、最小 TTC 1.08 秒；这只说明链路通了，不能当成路面成绩。实物样机和封闭场地实测还在进行，计划见第16页。

## Slide 15

04 验证情况

理论计算：雷达距离能留出多少时间

t = 100 m ÷ 车速（按标称最远探测距离，实际距离需实测）

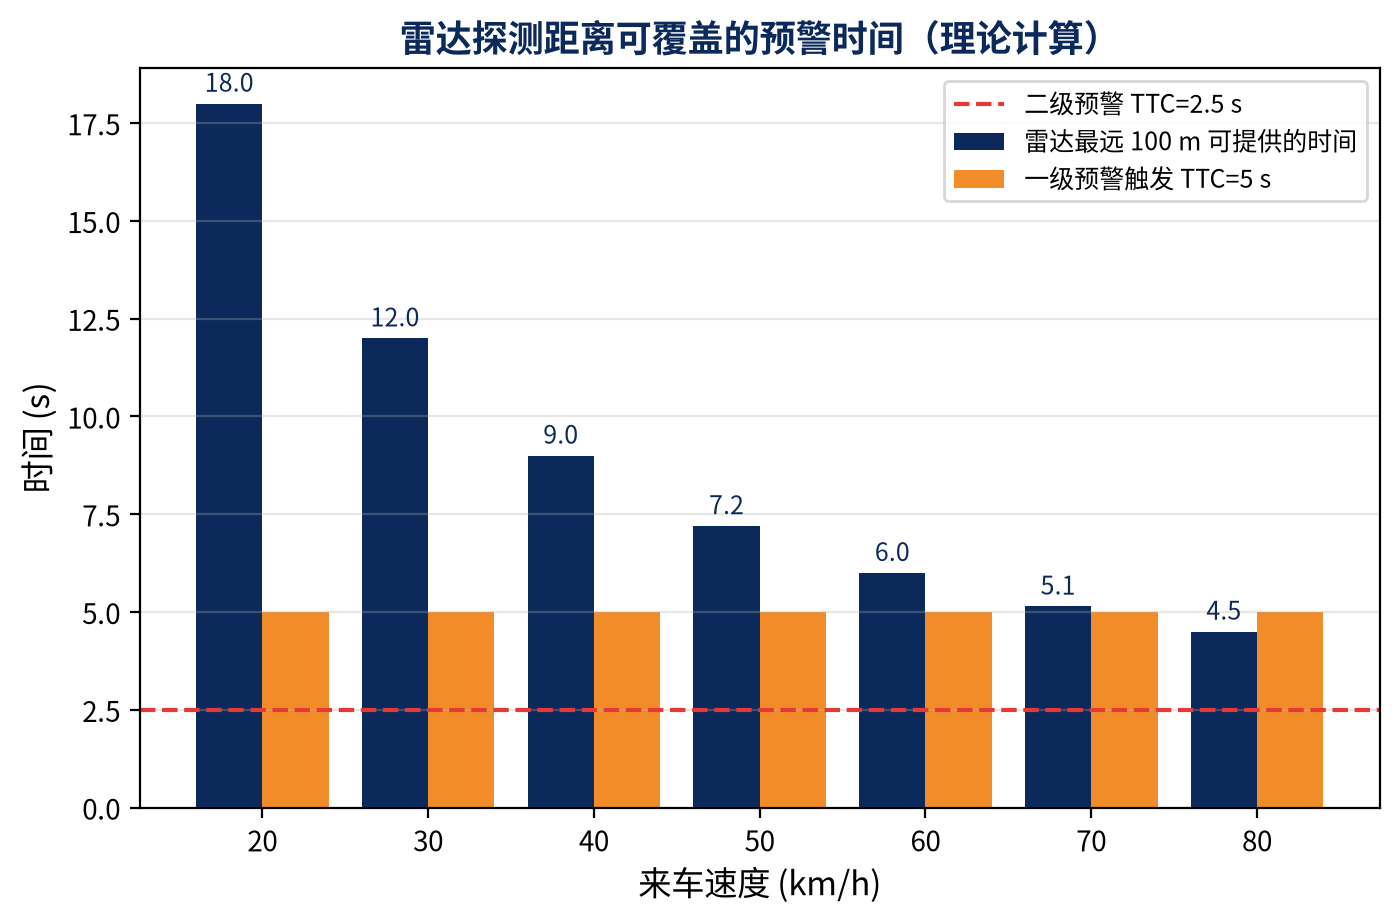
[picture p30: figure]

9.0 s

车速 40 km/h 时

6.0 s

车速 60 km/h 时

72 km/h 以上
不足 5 s，但已超过 40×1.2 km/h，按超速触发一级

哨兵 · 公路养护作业区智能预警锥桶

15

Notes: 这是理论计算：按雷达标称最远100米，40公里每小时约有9秒，60公里每小时约6秒，都大于5秒的一级阈值；车速超过72公里每小时时不足5秒，但这时已经超过40×1.2公里每小时的超速线，会按超速条件提前触发一级。局限：安装高度、车型、天气都会影响实际探测距离，要实测确认；高速路段可以研究前后两个哨兵级联，作为后续工作。

## Slide 16

04 验证情况

待完成：封闭场地实测计划

目标值为团队自定的验收线，实测后填入右列

指标 | 目标值 | 实测值
测速误差 | ≤ ±3 km/h | 【待实测】
测距误差 | ≤ ±2 m | 【待实测】
最远稳定检测距离 | ≥ 80 m | 【待实测】
一级预警提前量 | ≥ 4 s | 【待实测】
误报率 | ≤ 5% | 【待实测】
漏报率 | ≤ 2% | 【待实测】
联动延迟 | ≤ 100 ms | 【待实测】
续航 | ≥ 8 h | 【待实测】

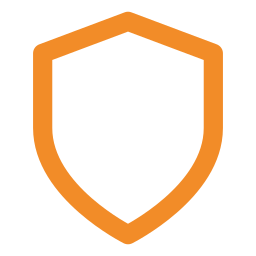
[picture p31: figure]

安全约束

封闭场地
自行车 / 电动车 ≤30 km/h
专人警戒
不用车辆冲向真人

哨兵 · 公路养护作业区智能预警锥桶

16

Notes: 这是封闭场地实测计划，目标值是团队自己定的验收线。测试方法：测速误差在10到30公里每小时五档各测5次，对比测速仪；测距误差在路面每10米做标记，对比雷达读数；最远稳定检测距离在白天、夜间、小雨各测5次；一级预警提前量用视频逐帧计时；误报率做30分钟无目标驶近观察；漏报率做20次超阈值驶近；联动延迟用慢动作视频逐帧测10次；续航满电连续运行。测试只在封闭场地用自行车或电动车，车速不超过30公里每小时，专人警戒，不用车辆冲向真人。【实测完成后把“待实测”格子替换为实测数据，口头说明测试日期、地点和次数】

## Slide 17

05 创新计划

作品特点

不是首创某项技术，而是面向小型养护作业的低成本集成

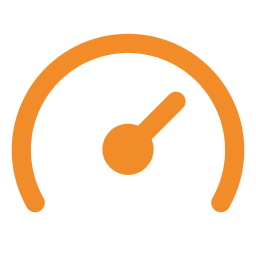
[picture p32: figure]

按危险程度提醒

流水灯引导

预警直达工人

TTC + 超速双判据分级

联动锥桶错相点亮

弥补背对来车的盲区

一句话部署

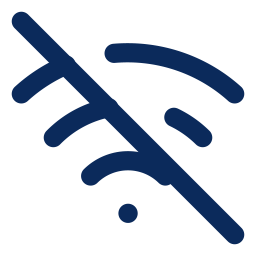
[picture p33: figure]

断网可用

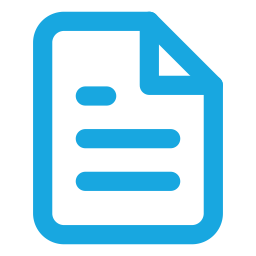
[picture p34: figure]

事件可追溯

离线语音切换作业与模式

本地判定，不依赖路由器

接近事件入库，出报告

哨兵 · 公路养护作业区智能预警锥桶

17

Notes: 总结六个特点：一是按危险程度提醒，TTC加超速双判据分级，平时慢闪、危险时才升级；二是流水灯引导，联动锥桶错相点亮指示变道方向；三是预警直达工人，二级预警送到工人身上，弥补背对来车的盲区；四是一句话部署，离线语音切换作业、封道方向和环境模式；五是断网可用，判定在锥桶本地完成，组网不依赖路由器；六是接近事件可追溯，每次危险接近入库并自动生成安全报告。我们不说首创某项技术，价值在于把这些功能集成到小型养护作业用得上的低成本锥桶里。

## Slide 18

05 创新计划

功能定位对比

按工作原理比较，不代表具体产品

对比项 | 锥桶 / 标志 | 爆闪警示灯 | 入侵报警类 | 哨兵（本作品）
工作方式 | 隔离、告知 | 固定频率闪烁 | 检测越界或碰撞 | 测距测速，算 TTC
触发时机 | — | 常亮 / 常闪 | 车辆越界后 | 接近途中分级
提醒对象 | 司机 | 司机 | 工人（视产品） | 司机 + 工人
数据记录 | 无 | 无 | 视产品而定 | 事件入库、报告
参考成本 | — | 【待补充】 | 【待补充】 | 物料约 350 元/套

入侵报警技术评估见 Gambatese 等（2017）[10]；本作品同样需要实测证明效果

【待补充：国内在售产品的名称、参数、价格及出处】

哨兵 · 公路养护作业区智能预警锥桶

18

Notes: 按工作原理比较，不代表具体产品：锥桶和标志负责隔离告知；爆闪灯固定频率闪烁；入侵报警类多在车辆越界后触发。本作品在车辆接近途中就按TTC分级，同时提醒司机和工人，并留下记录。入侵报警技术的评估可参考Gambatese等2017年的报告，本作品同样需要实测证明效果。各类产品价格我们还在调研，没有数据之前不做价格比较。【待补充：国内在售产品的名称、参数、价格及出处】

## Slide 19

05 创新计划

应用场景与推广路径

适用对象：公路养护、市政养护和占道施工单位

557.89 万公里

471.12 万公里

19.94 万公里

全国公路里程

其中农村公路

高速公路

数据：交通运输部《2025年交通运输行业发展统计公报》[1]，2025 年末

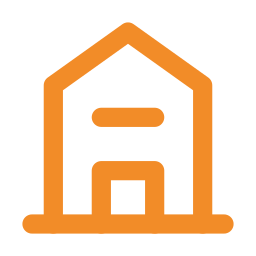
[picture p35: figure]
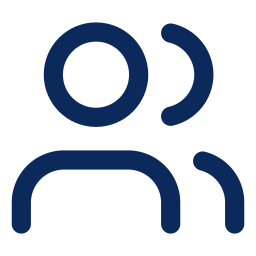
[picture p36: figure]
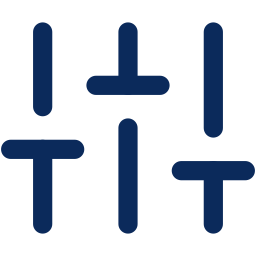
[picture p37: figure]
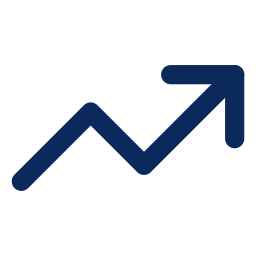
[picture p38: figure]

校内

样机演示 · 封闭场地实测

试用

联系养护单位短期试用

改进

按反馈标定阈值、优化续航

推广

小批量制作，形成使用指南

政策方向：交通强国建设纲要 [4] · 公路数字化转型 [5] · 治本攻坚 [6]

哨兵 · 公路养护作业区智能预警锥桶

【待补充：已联系的养护单位及试用意向】

19

Notes: 到2025年末，全国公路里程557.89万公里，其中农村公路471.12万公里（县道70.57、乡道124.03、村道276.52万公里），高速公路19.94万公里，日常小修保养点多面广。适用对象是公路养护、市政养护和占道施工单位。作品方向与交通强国建设纲要、公路数字化转型意见和安全生产治本攻坚三年行动一致。推广分四步：校内样机演示与封闭场地实测、联系养护单位短期试用、按反馈标定阈值并优化外壳与续航、小批量制作并形成使用指南。【有试用意向时在此补充】

## Slide 20

05 创新计划

不足、下一步与团队

坦诚说明短板，按优先级推进

01

实测数据

团队分工

成员 | 专业 | 分工
【填】（负责人） | 【填】 | 调研、算法、申报书
【填】 | 【填】 | 硬件、电路、固件
【填】 | 【填】 | 组网、平台
【填】 | 【填】 | 外壳、调研、答辩

指导教师：【填】
专利 / 软著 / 获奖：【填：没有就写“暂无”】

封闭场地测试，标定阈值与系数

02

方向判别

LD2451 接近/远离方向需实机核对

03

通信安全

ESP-NOW 未加密，计划加校验与配对

04

工程化

外壳防水、续航测试、PCB 一体化

哨兵 · 公路养护作业区智能预警锥桶

20

Notes: 作品目前还有不足：一是缺少实测数据，阈值和环境系数需要在封闭场地标定；二是LD2451雷达接近和远离方向的判别要实机核对；三是ESP-NOW广播没有加密，计划加入报文校验与配对；四是外壳防水、续航测试和PCB一体化还要做。团队分工如右表：负责人负责需求调研、预警算法和申报书，其余成员分别负责硬件电路与固件、组网与平台、外壳调研与答辩。【团队信息、指导教师和成果按实际填写】

## Slide 21

05 创新计划

参考资料（1/2）

均为公开资料，已逐条打开核对（2026-11-01）

[1] 交通运输部. 2025年交通运输行业发展统计公报[EB/OL]. (2026-06-22)
[2] 交通运输部. 关于发布《公路养护安全作业规程》的公告（2015年第16号）[EB/OL]
[3] 国家质量监督检验检疫总局, 国家标准化管理委员会. 道路交通标志和标线 第4部分：作业区: GB 5768.4—2017[S]
[4] 中共中央, 国务院. 交通强国建设纲要[Z]. 国务院公报, 2019(28)
[5] 交通运输部. 关于推进公路数字化转型 加快智慧公路建设发展的意见: 交公路发〔2023〕131号[Z]
[6] 应急管理部. 国务院安委会部署开展安全生产治本攻坚三年行动[EB/OL]. (2024-02-05)
[7] U.S. Government. 23 CFR 630.1108 Work zone safety management measures and strategies[S]
[8] Federal Highway Administration. 2026 National Work Zone Awareness Week Fact Sheet: FHWA-HOP-26-060[R]. 2026

哨兵 · 公路养护作业区智能预警锥桶

21

Notes: 参考资料链接：
[1] https://xxgk.mot.gov.cn/jigou/zhghs/202606/t20260618_4207752.html
[2] https://xxgk.mot.gov.cn/jigou/glj/202006/t20200623_3312282.html
[3] https://openstd.samr.gov.cn/bzgk/std/newGbInfo?hcno=81495E87EE21D71FCC2759945539504F
[4] https://www.gov.cn/gongbao/content/2019/content_5437132.htm
[5] https://xxgk.mot.gov.cn/jigou/glj/202309/t20230920_3922478.html
[6] https://www.mem.gov.cn/xw/yjglbgzdt/202402/t20240205_477370.shtml
[7] https://www.ecfr.gov/current/title-23/chapter-I/subchapter-G/part-630/subpart-K/section-630.1108
[8] https://ops.fhwa.dot.gov/publications/HOP-26-060_FHWA_NWZAW_Factsheet.pdf

## Slide 22

05 创新计划

参考资料（2/2）

均为公开资料，已逐条打开核对（2026-11-01）

[9] Federal Highway Administration. EDC-8: Advancing Nighttime Work Zone Safety[EB/OL]
[10] Gambatese J A, Lee H W, Nnaji C A. Work zone intrusion alert technologies: assessment and practical guidance: FHWA-OR-RD-17-14[R]. Oregon DOT, 2017
[11] Hayward J C. Near-miss determination through use of a scale of danger[J]. Highway Research Record, 1972, 384: 24-34
[12] Kalman R E. A new approach to linear filtering and prediction problems[J]. Journal of Basic Engineering, 1960, 82(1): 35-45
[13] 深圳市海凌科电子有限公司. HLK-LD2451 使用手册 V1.03[Z]. 2024
[14] 深圳市海凌科电子有限公司. LD2451 串口通信协议 V1.03[Z]. 2024
[15] Espressif Systems. ESP-NOW: ESP-IDF Programming Guide (ESP32-C3)[EB/OL]
[16] 泰州市公安局. 345国道泰州靖江市“1·7”较大道路交通事故处理情况公示[EB/OL]. (2026-10-26)

哨兵 · 公路养护作业区智能预警锥桶

22

Notes: 参考资料链接：
[9] https://www.fhwa.dot.gov/innovation/everydaycounts/edc_8/nighttime_work_zone_safety.cfm
[10] https://rosap.ntl.bts.gov/view/dot/32574
[11] https://onlinepubs.trb.org/Onlinepubs/hrr/1972/384/384-004.pdf
[12] https://asmedigitalcollection.asme.org/fluidsengineering/article-abstract/82/1/35/397706/A-New-Approach-to-Linear-Filtering-and-Prediction
[13] https://h.hlktech.com/download/HLK-LD2451-24G/1/HLK-LD2451%E4%BD%BF%E7%94%A8%E6%89%8B%E5%86%8C_V1.03%20.pdf
[14] https://h.hlktech.com/download/HLK-LD2451-24G/1/LD2451%20%E4%B8%B2%E5%8F%A3%E9%80%9A%E4%BF%A1%E5%8D%8F%E8%AE%AE%20V1.03.pdf
[15] https://docs.espressif.com/projects/esp-idf/en/stable/esp32c3/api-reference/network/esp_now.html
[16] https://gaj.taizhou.gov.cn/jwzx/tzgg/art/2026/art_d692699ed0c944bcaa4fa840ed0461ea.html

## Slide 23

让锥桶测到来车，让提醒早几秒

守护养护工人平安回家

恳请各位评委老师批评指正

Notes: 我们希望让锥桶测到来车，让提醒早几秒，守护养护工人平安回家。汇报完毕，恳请各位评委老师批评指正。
