wy165611/smart-warning-cone/competition/challenge-cup/img/flow.png

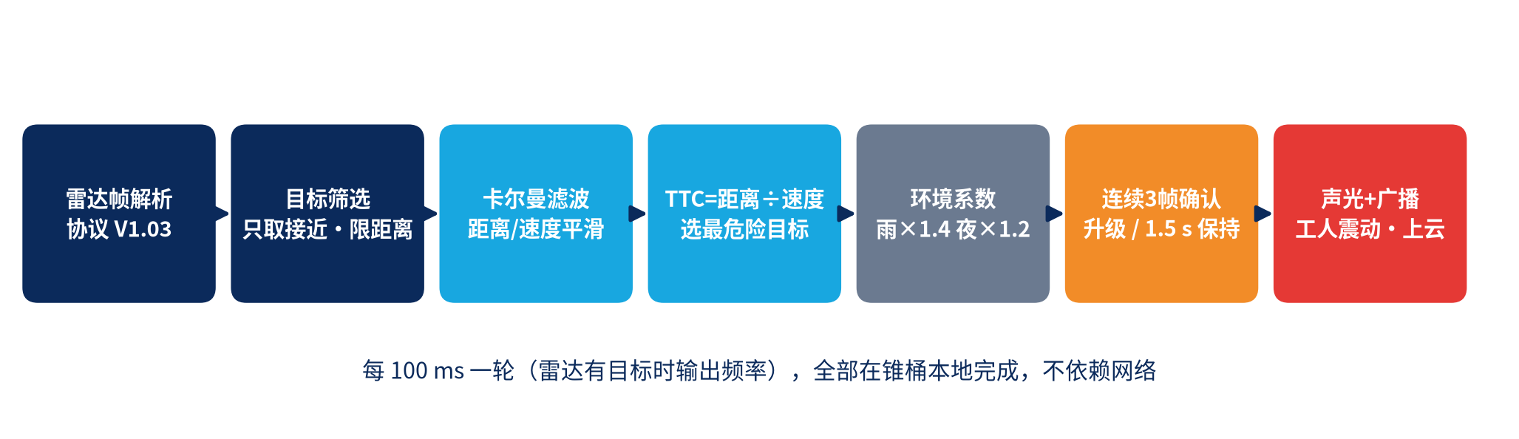
competition/challenge-cup/img/flow.png
