wy165611/smart-warning-cone/competition/challenge-cup/img/workzone.png

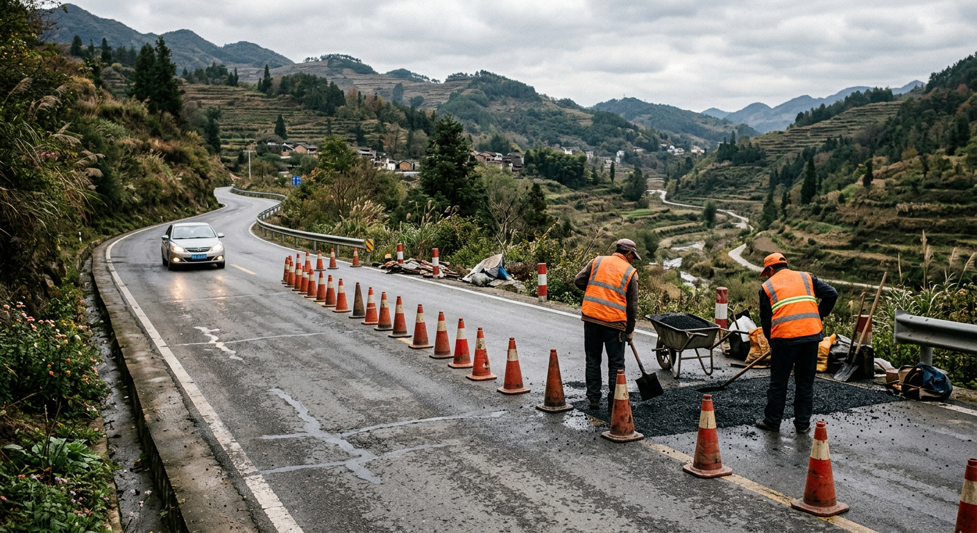
competition/challenge-cup/img/workzone.png
