wy165611/smart-warning-cone/docs/02-物料清单BOM.md

# 物料清单（BOM）

价格为网店常见标价的**估算**，不是报价单，以实际下单为准。【待补充：实际采购票据】演示套装：1 个哨兵 + 2 个联动 + 1 个工人端 + 1 个网关。申报书、PPT 中的“哨兵约 115 元、套装约 350 元”都出自本表。

## 1. 哨兵锥桶（×1）

| # | 器件 | 规格/型号 | 数量 | 参考价 | 淘宝搜索关键词 |
|---|---|---|---|---|---|
| 1 | 主控 | ESP32-C3 SuperMini 或 ESP32-C3-DevKitM-1 | 1 | 12 | ESP32-C3 SuperMini |
| 2 | 毫米波雷达 | 海凌科 HLK-LD2451（24GHz 车辆检测，带插针） | 1 | 30–45 | LD2451 雷达 |
| 3 | 灯带 | WS2812B 5V，60 灯/米，取 30 灯（0.5 m），IP65 | 1 | 10 | WS2812B 灯带 IP65 |
| 4 | 蜂鸣器 | 5V 有源蜂鸣器（或 85dB 以上报警器） | 1 | 2 | 有源蜂鸣器 5V |
| 5 | MOSFET | AO3400（SOT-23）或 IRLZ44N（直插，好焊） | 1 | 1 | AO3400 |
| 6 | 语音模块 | ASRPRO V2.0 + 4Ω 3W 喇叭 + 麦克风 | 1 | 25 | ASRPRO 语音模块 |
| 7 | 电池 | 18650 锂电 3000 mAh | 1 | 10 | 18650 3000mAh |
| 8 | 电池座 | 18650 单节电池盒（带线） | 1 | 2 | 18650 电池盒 |
| 9 | 充电保护 | TP4056 Type-C 带保护板 | 1 | 2 | TP4056 Type-C 保护 |
| 10 | 升压 | MT3608 或 5V 2A 升压模块（雷达需 5V >200mA） | 1 | 3 | 5V 升压模块 2A |
| 11 | 电阻 | 330Ω×1（灯带）、10k×1（MOSFET 下拉）、100k×2（电池分压） | 若干 | 1 | 电阻包 |
| 12 | 电容 | 1000µF/10V 电解（灯带电源滤波） | 1 | 1 | 1000uF 10V |
| 13 | 开关 | 船型/拨动电源开关 | 1 | 1 | 拨动开关 |
| 14 | 其他 | 洞洞板/杜邦线/XH2.54 端子 | 若干 | 5 | — |
| | **小计** | | | **约 105–120** | |

## 2. 联动锥桶（×2，每个）

| 器件 | 数量 | 参考价 |
|---|---|---|
| ESP32-C3 SuperMini | 1 | 12 |
| WS2812B 30 灯 | 1 | 10 |
| 有源蜂鸣器 + AO3400 + 电阻 | 1 套 | 3 |
| 18650 + 电池盒 + TP4056 + 升压 | 1 套 | 17 |
| 电容、开关、杜邦线 | — | 3 |
| **小计** | | **约 45** |

## 3. 工人报警器（×1）

| 器件 | 数量 | 参考价 |
|---|---|---|
| ESP32-C3 SuperMini | 1 | 12 |
| 扁平振动马达（1027 型，3V） | 1 | 2 |
| 有源蜂鸣器 + AO3400 ×2 + 1N4148 二极管（马达续流） | 1 套 | 3 |
| 红色 LED + 220Ω | 1 | 0.5 |
| 轻触按键 | 1 | 0.5 |
| 小锂电 500 mAh（带保护）+ TP4056 | 1 套 | 10 |
| 魔术贴绑带/背夹 | 1 | 3 |
| **小计** | | **约 31** |

> 供电说明：工人端不带升压模块，锂电（3.7–4.2 V）接开发板 5V 引脚，经板载 LDO 降到 3.3 V。电池低于约 3.5 V 时 LDO 可能失去稳压，应及时充电。不同开发板的 LDO 型号不同，以所用板子的原理图为准。【待实测：工人端续航与低电压下的工作情况】

## 4. 网关（×1）

| 器件 | 数量 | 参考价 |
|---|---|---|
| ESP32 / ESP32-C3 开发板（USB 供电） | 1 | 12 |
| **小计** | | **约 12** |

## 5. 结构与工具

| 物品 | 说明 | 参考价 |
|---|---|---|
| 交通锥桶 70 cm | 3 个，用于演示 | 15/个 |
| 3D 打印外壳 | 灯头模块，PETG 材质更耐晒 | 自打或代打 20–50 |
| 防水接头/热缩管/热熔胶 | — | 10 |
| USB-TTL（CH340） | 电脑直连雷达调试 | 5 |
| 万用表、电烙铁 | 实验室已有可不买 | — |

## 6. 合计

| 项目 | 金额 |
|---|---|
| 哨兵 ×1 | ≈ 115 |
| 联动 ×2 | ≈ 90 |
| 工人端 ×1 | ≈ 31 |
| 网关 ×1 | ≈ 12 |
| 锥桶、外壳、辅料 | ≈ 100 |
| **演示套装总计** | **≈ 350 元** |

## 选型备注

- **雷达**：LD2451 专为车辆检测设计（最远约 100 m，水平 ±15°），供电 5V 且要求 >200 mA，平均电流约 107 mA，不能直接用 ESP32 的 3.3V 供电。
- **为什么不用超声波**：超声波作用距离只有数米量级，来不及提供以秒计的提前量（工程判断，未做对比试验）。
- **为什么不用摄像头**：需要更强的算力和补光，夜间和雨雾下效果受影响，还涉及拍摄路人和车牌的隐私问题。毫米波雷达受光照影响小，厂家把 LD2451 定位为室外车辆检测；雨雾中的实际表现【待实测】。摄像头可作为“升级版”方向（如 ESP32-S3 做车型识别）。
- **主控升级**：需要更多 IO 或摄像头时用 ESP32-S3。
