wy165611/smart-warning-cone/competition/challenge-cup/答辩PPT_待补充清单.md

# 答辩 PPT 待补充清单

由 gen_ppt.py 自动生成，勿手改。页面上以灰色虚线标签或浅灰底纹显示，答辩前据实替换。

| 页 | 占位内容 | 处数 |
|---|---|---|
| 1 | 【填】 | 3 |
| 1 | 【请核对】 | 1 |
| 1 | 校徽 | 1 |
| 12 | 【待补充：实际采购价】 | 1 |
| 13 | 【待补充：实际采购价与发票】 | 1 |
| 16 | 【待实测】 | 8 |
| 18 | 【待补充】 | 2 |
| 18 | 【待补充：国内在售产品的名称、参数、价格及出处】 | 1 |
| 19 | 【待补充：已联系的养护单位及试用意向】 | 1 |
| 20 | 【填】（负责人） | 1 |
| 20 | 【填】 | 8 |
| 20 | 【填：没有就写“暂无”】 | 1 |
