wy165611/smart-warning-cone/(commit log)

2026-10-31 初始化：哨兵智能预警锥桶完整项目（申报书、BOM、接线、固件、语音、后端看板、测试方案）
2026-10-31 自查修复：串口对象复用、序号去重与重启兼容、网关经中继收包、模拟器更真实、新增公共头同步脚本；四个固件编译通过
2026-10-31 新增挑战杯（大挑·科技发明制作B类）作品申报书与答辩PPT及生成脚本
2026-11-01 整理哨兵为可测试的软件包，并补上竞赛说明书
    修复 MQTT 坏包中断订阅、联动去重槽位过少、序号 0 被丢弃这几处实现问题。把算法、雷达帧和入库抽成带类型的 Python 包，补上 pytest 与 ruff 配置。README 改为中文产品说明，项目说明书只引用核对过的公开资料。
    [follower.ino, gateway.ino]
2026-11-01 修正报告舍入、TTC 选目标与一处过时注释
    安全报告的小数按看板的 toFixed 进位，避免 .5 在两边显示成不同的数。选最危险目标时与固件一样，TTC 必须严格小于 99 秒。联动锥桶的注释改成现在的序号去重行为。
    [follower.ino]
2026-11-01 修正网关信道打印的格式警告，并写明 ESP32-C3 上 GPIO0/GPIO1 的实际用途。
    WiFi.channel() 在本核心里是 int32_t，%d 会告警。对照乐鑫手册后保持电池接 GPIO0、按键接 GPIO1，不改线。
    [gateway.ino, sentinel.ino, worker.ino]
2026-11-01 固件：哨兵按时间解除告警（雷达无帧时不再卡住），联动锥桶转发模式包，网关对全部报文按序号去重
2026-11-01 新增序号去重参考实现与固件/Python 对账测试，报告标题按实际条数显示
2026-11-01 看板两栏布局、24 小时制时间、离线提示；修正示例报告条数并加入模拟器截图
2026-11-01 构建：Makefile 增加 test/lint/sync/firmware/competition 目标，新增 competition 依赖组，README 更新编译状态与看板截图
2026-11-01 文档：按代码核对引脚、阈值与组网规则，删除无出处说法，补充已打开核对的参考资料与待补充项
2026-11-01 挑战杯：申报书与答辩 PPT 重写，共享 facts.py 保证数字一致，参考资料逐条核对，未实测内容标黄待补充
2026-11-01 挑战杯答辩 PPT v2：投影可读版——正文≥16pt、细节移入备注、去卡片多留白、线条图标与大图、待补充占位弱化为灰色虚线标签并自动生成清单，参考资料拆两页（共 23 页）
2026-11-04 修正预警状态机、序号去重和离线看板 (#1)
    * 修正非作业误跟踪和迟到告警复活，看板改为离线可用
    非作业模式不再累计确认或写入通过事件，结束作业会立刻解除。
    工人端与联动锥桶、网关共用序号去重，避免中继旧包把二级告警重新打开。
    联动中继改为队列发送，灯带不再每圈刷新。入库拒绝非有限数，半包心跳不再抹掉原值。
    看板随仓库带上 Chart.js 4.4.6。pytest 34 项与 ruff 通过；本次固件改动尚未重新编译。
    * 补上 2026-11-03 的固件编译结果和模拟器联调
    四个草图用 ar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
    [asrpro_sentinel.c, config.h, facts.py, follower.ino, gateway.ino]
2026-11-04 docs(挑战杯): 补充泰州345国道靖江养护区追尾国内案例
    依据泰州市公安局「1·7」公示写入申报书、答辩PPT与项目说明书；全国汇总统计仍待补。
