wy165611/smart-warning-cone/(notices)

Notices in the files:
README.md:
License: MIT
